dl9lj/station/Block.pdf

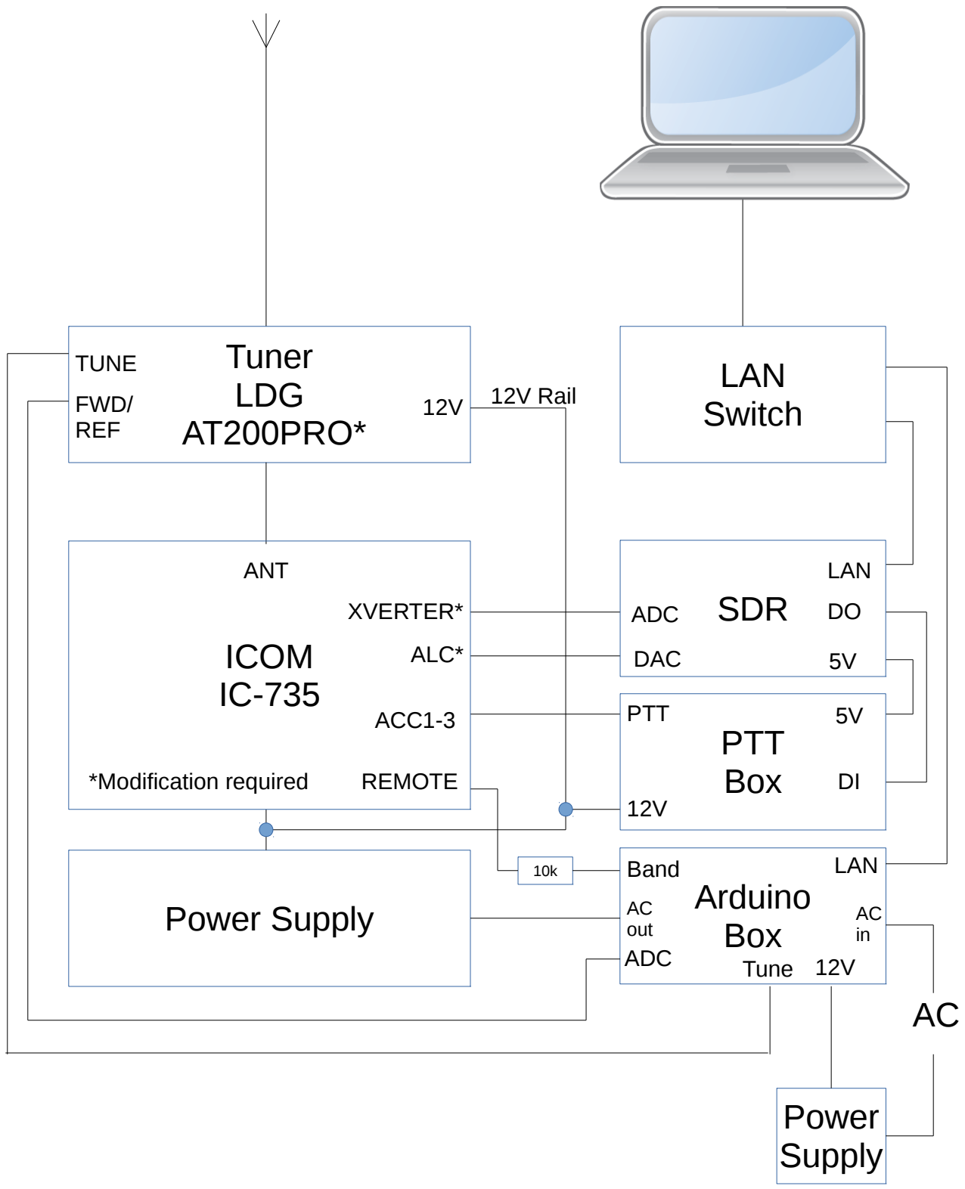
[picture p14: figure]
REMOTE; ADC; DAC; XVERTER*; ALC*; ACC1-3; ANT; *Modification required; Arduino Box Power Supply; LAN; Tuner LDG AT200PRO*; Band; Tune; TUNE; FWD/ REF; Power Supply; PTT; AC out; 12V Rail; ICOM IC-735; SDR; PTT Box; LAN Switch
