dl9lj/station/arduino_box/Arduino_Box.pdf

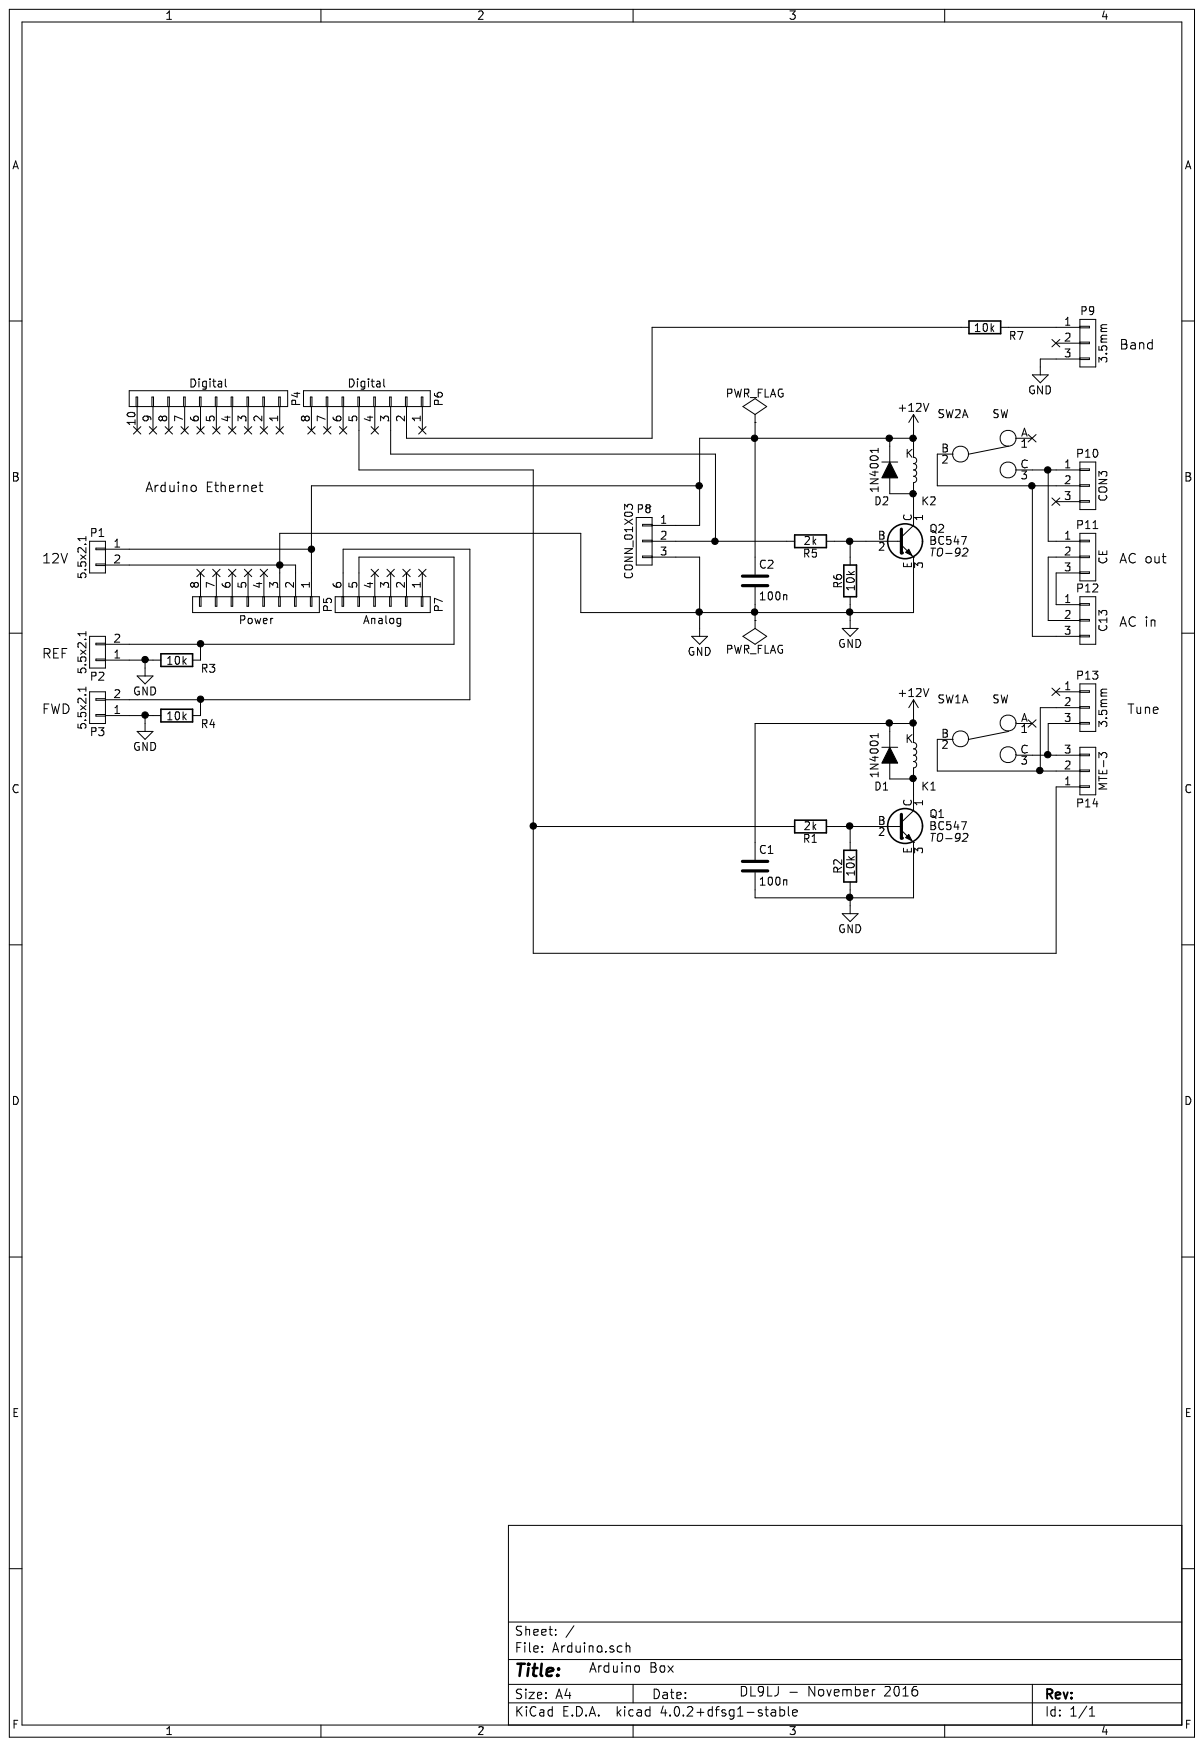
[picture p15: page 1]
