dl9lj/station/tuner/Tuner.pdf

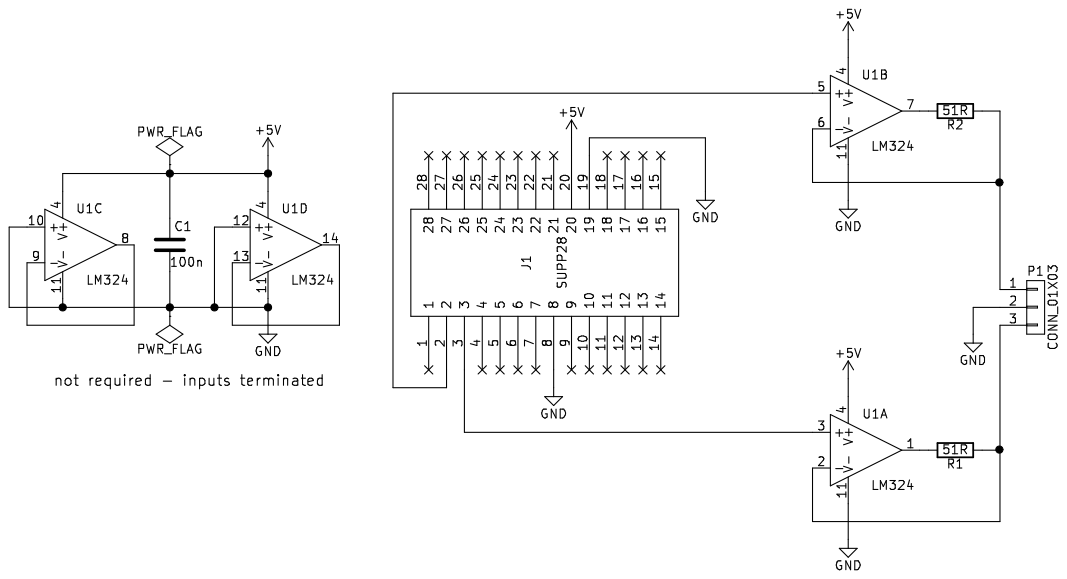
[picture p16: page 1]
