dl9lj/station/ptt_box/PTT_Box.pdf

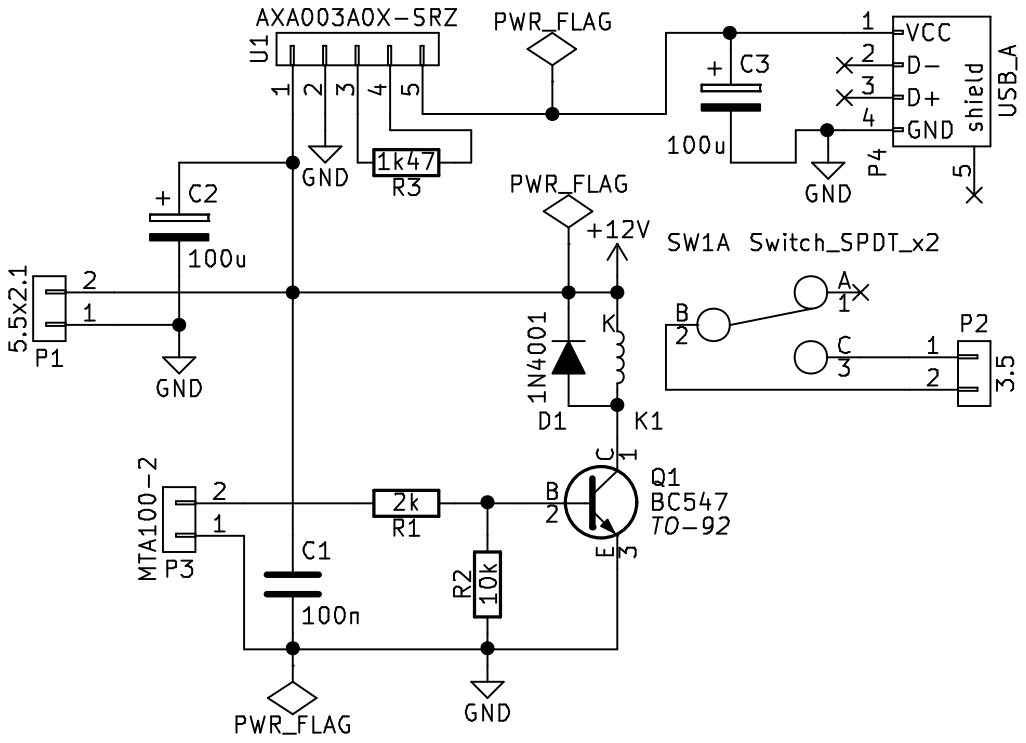
[picture p17: page 1]
