dl9lj/station/(commit log)

2016-11-07 arduino code
2016-11-11 kicad schematics
    [Arduino.kicad_pcb, Arduino.sch, PTT.kicad_pcb, PTT.sch, Tuner.kicad_pcb, Tuner.sch]
